GabiNeres/sistema-de-irrigacao/README.md

# sistema-de-irrigacao
Arquivos do trabalho de conclusão de curso -  Técnico em informática
